BOVAGE/glucosense/prototype/diagrams/1_system_architecture.png

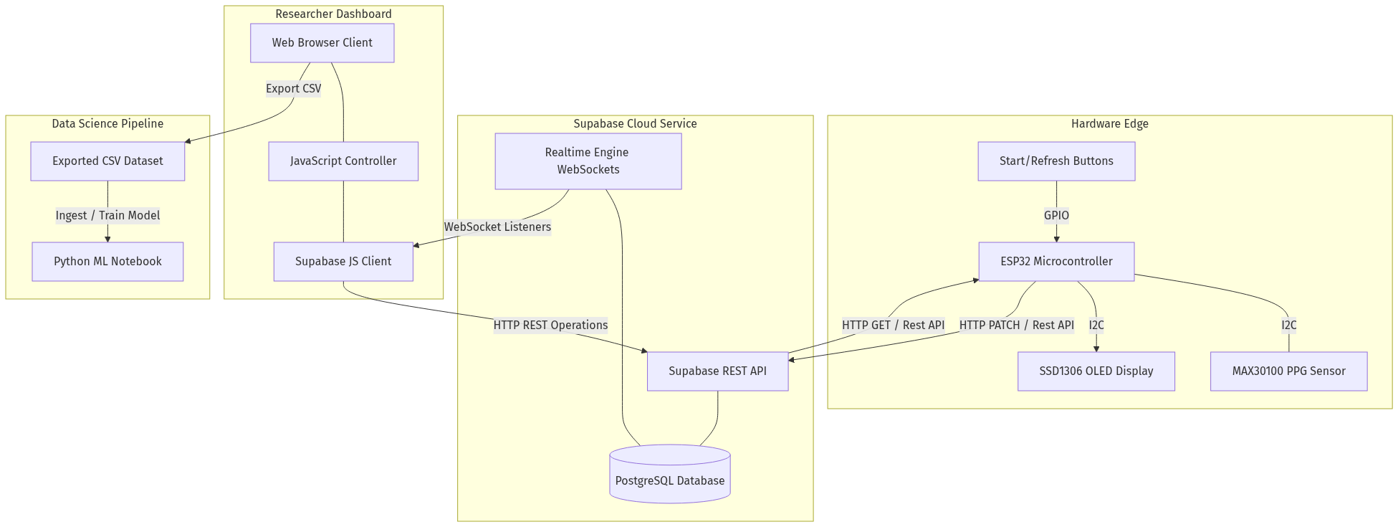
prototype/diagrams/1_system_architecture.png
