BOVAGE/glucosense/prototype/diagrams/2_database_schema.png

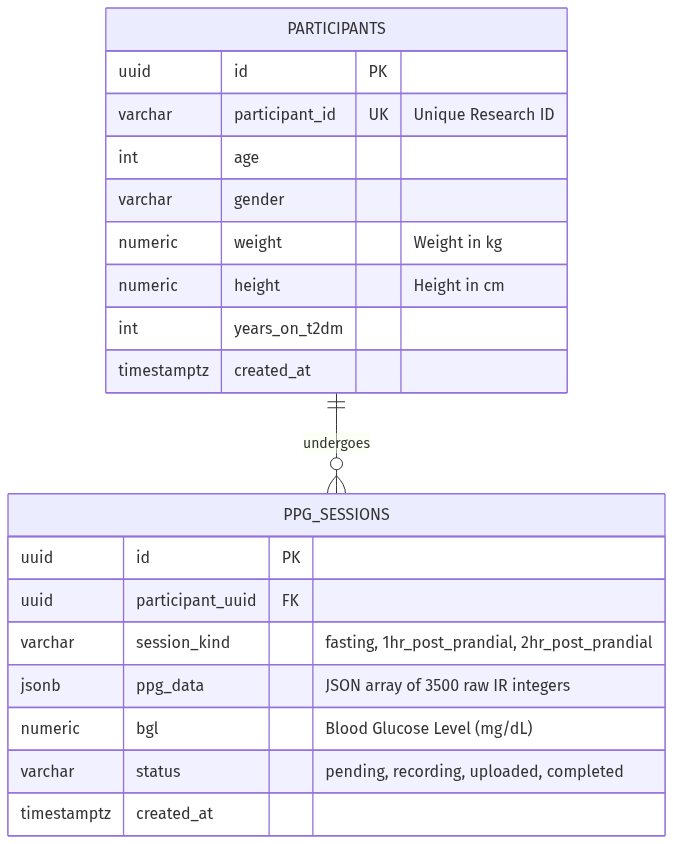
prototype/diagrams/2_database_schema.png
