BOVAGE/glucosense/prototype/diagrams/3_use_cases.png

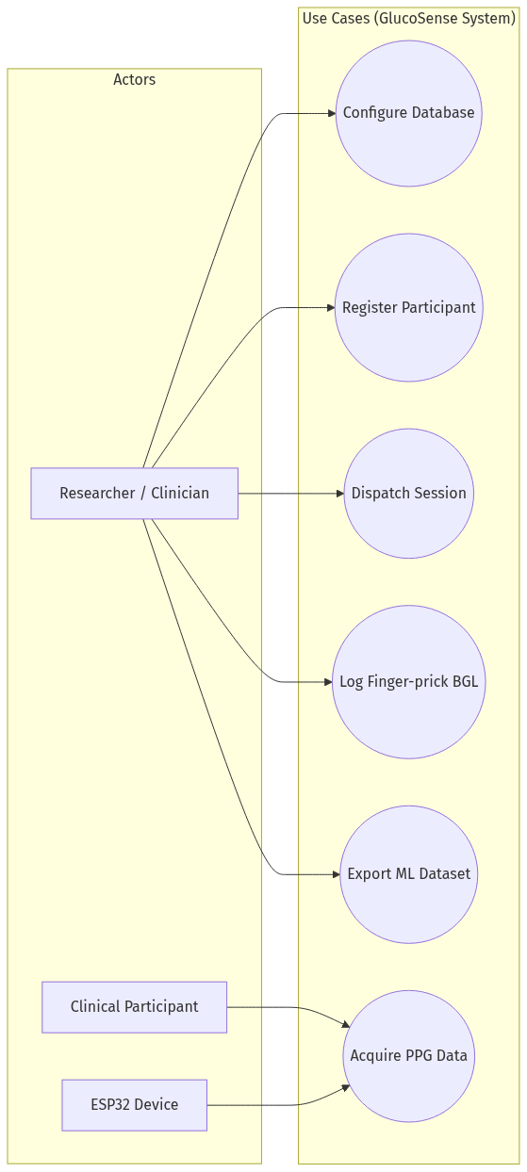
prototype/diagrams/3_use_cases.png
