BOVAGE/glucosense/prototype/diagrams/4_system_sequence_flow.png

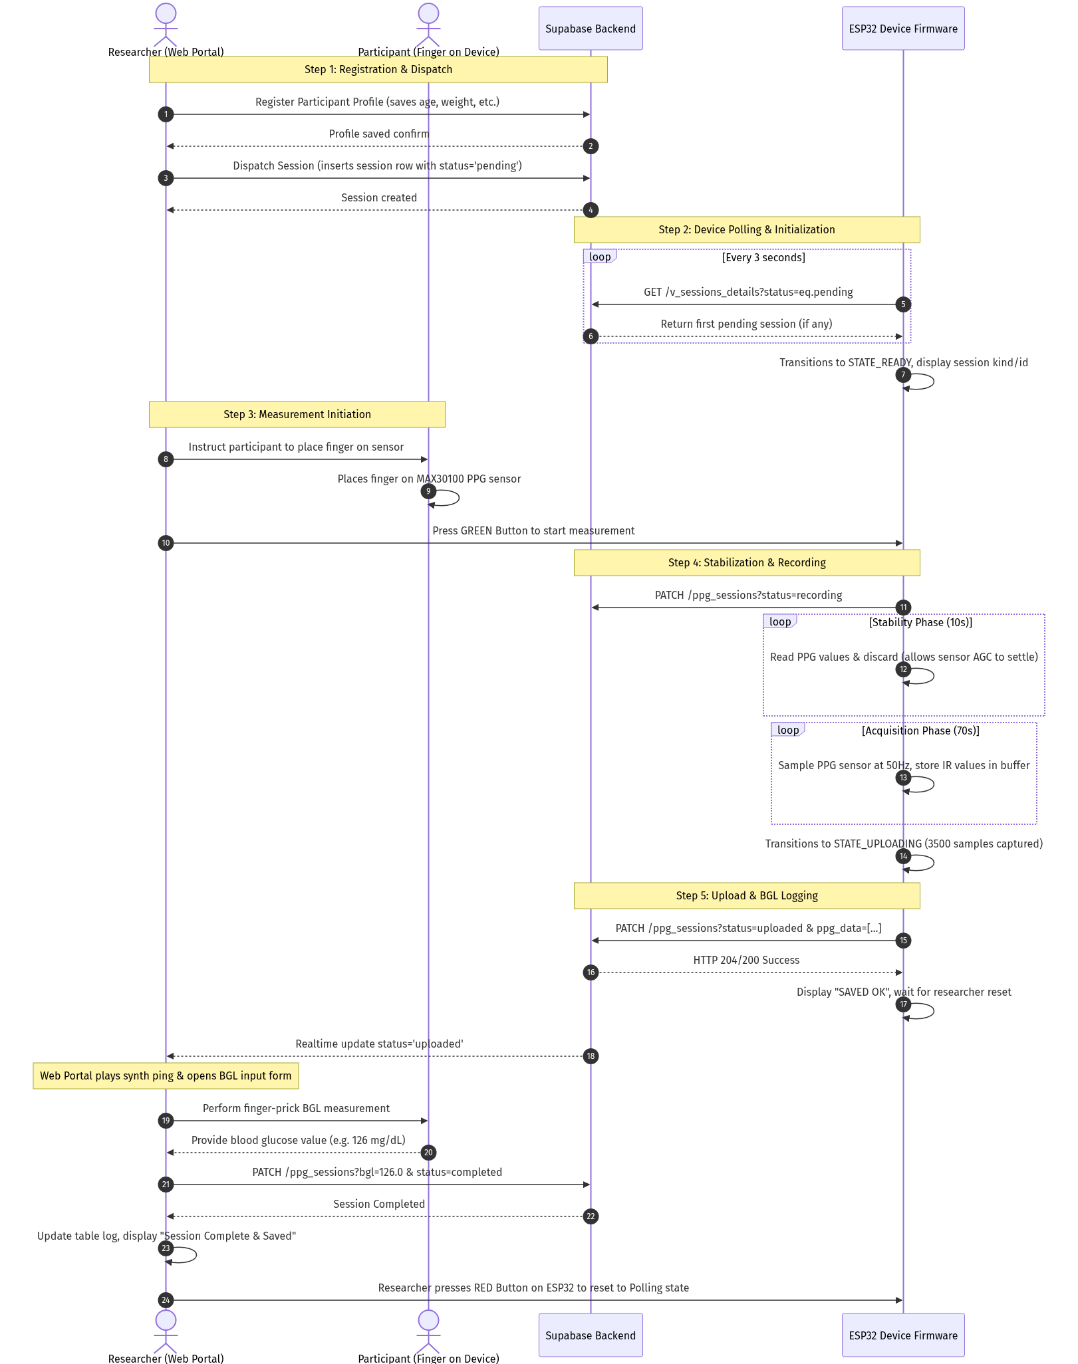
prototype/diagrams/4_system_sequence_flow.png
