BOVAGE/glucosense/prototype/diagrams/5_firmware_state_transitions.png

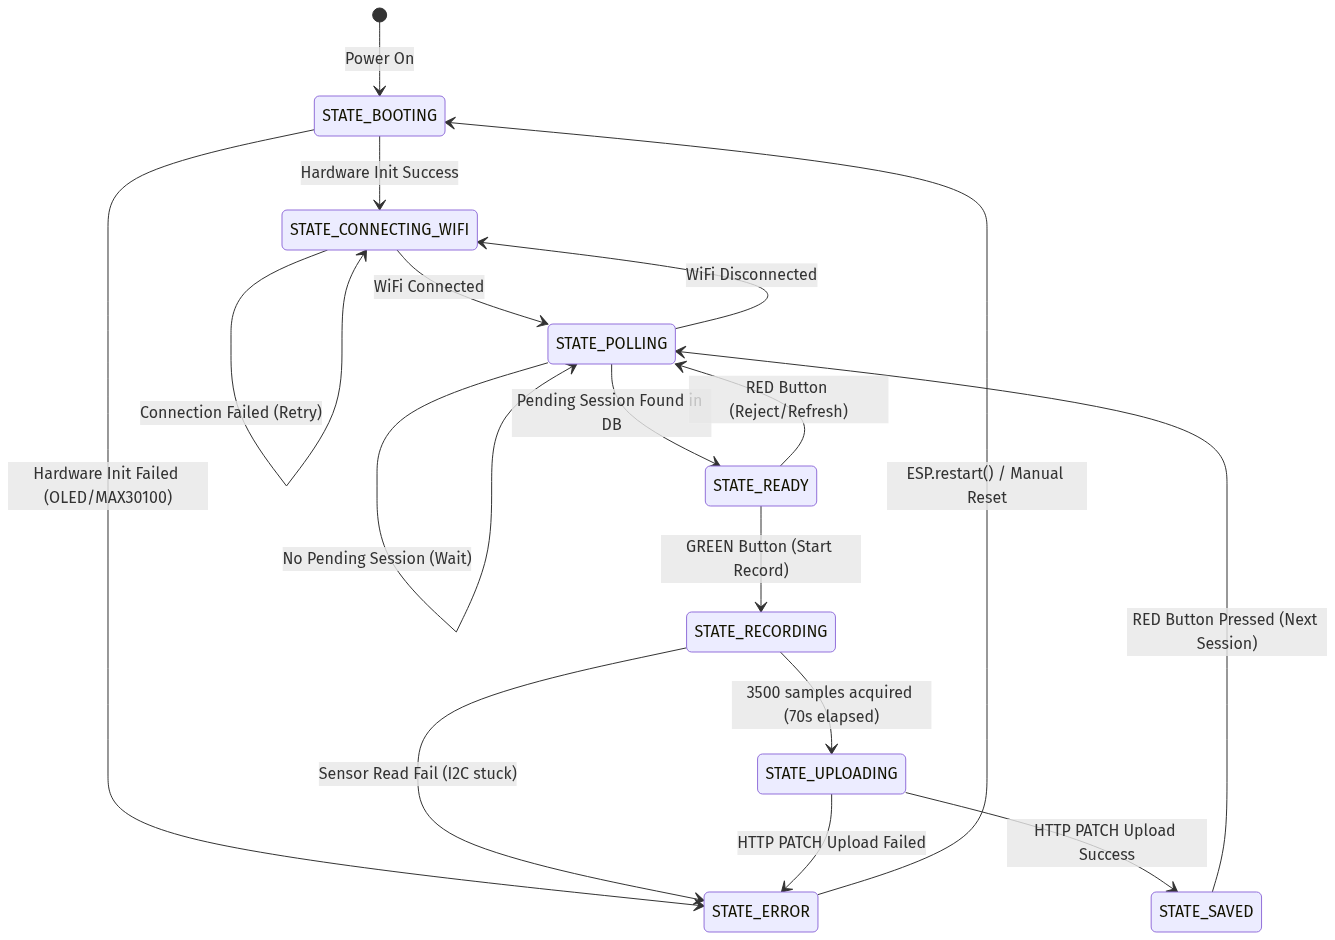
prototype/diagrams/5_firmware_state_transitions.png
