BOVAGE/glucosense/prototype/diagrams/6_device_functionality_flowchart.png

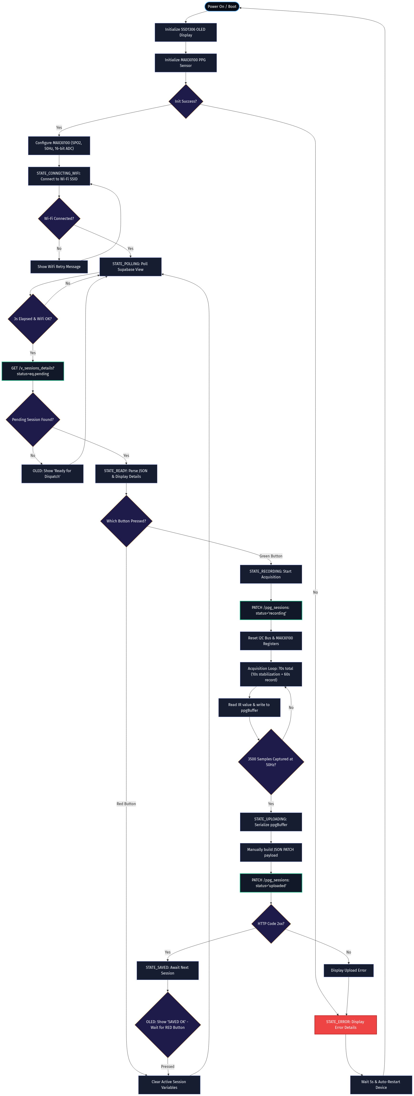
prototype/diagrams/6_device_functionality_flowchart.png
