BOVAGE/glucosense/prototype/diagrams/7_software_system_architecture.png

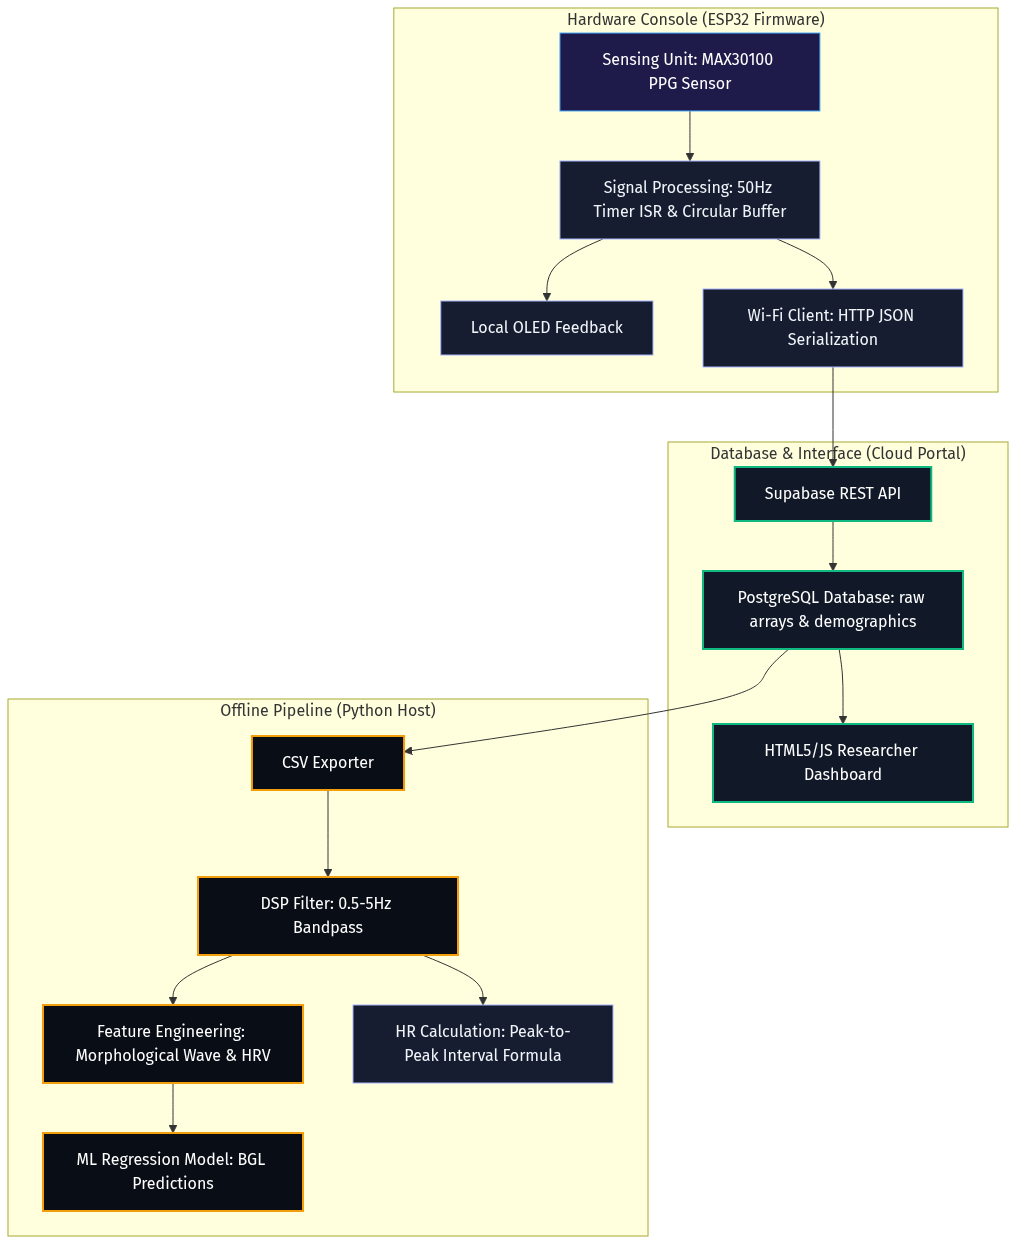
prototype/diagrams/7_software_system_architecture.png
