BOVAGE/glucosense/prototype/diagrams/diagram_2.png

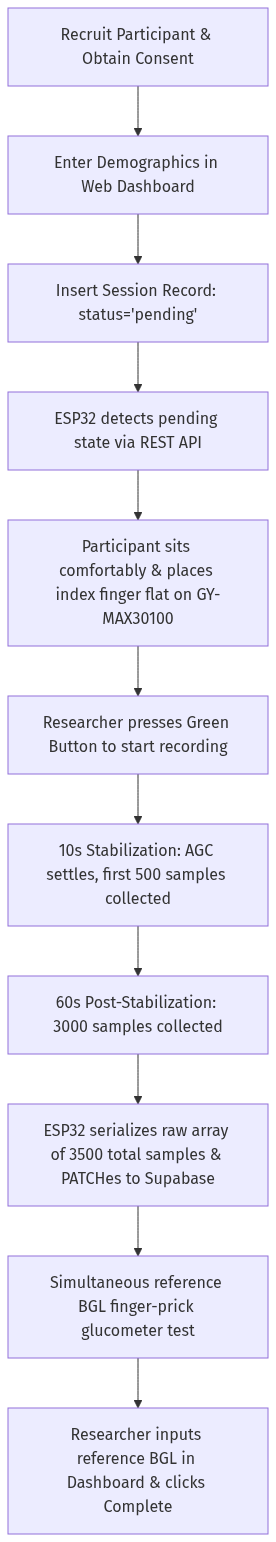
prototype/diagrams/diagram_2.png
