BOVAGE/glucosense/prototype/docs/fyp_circuit.pdf

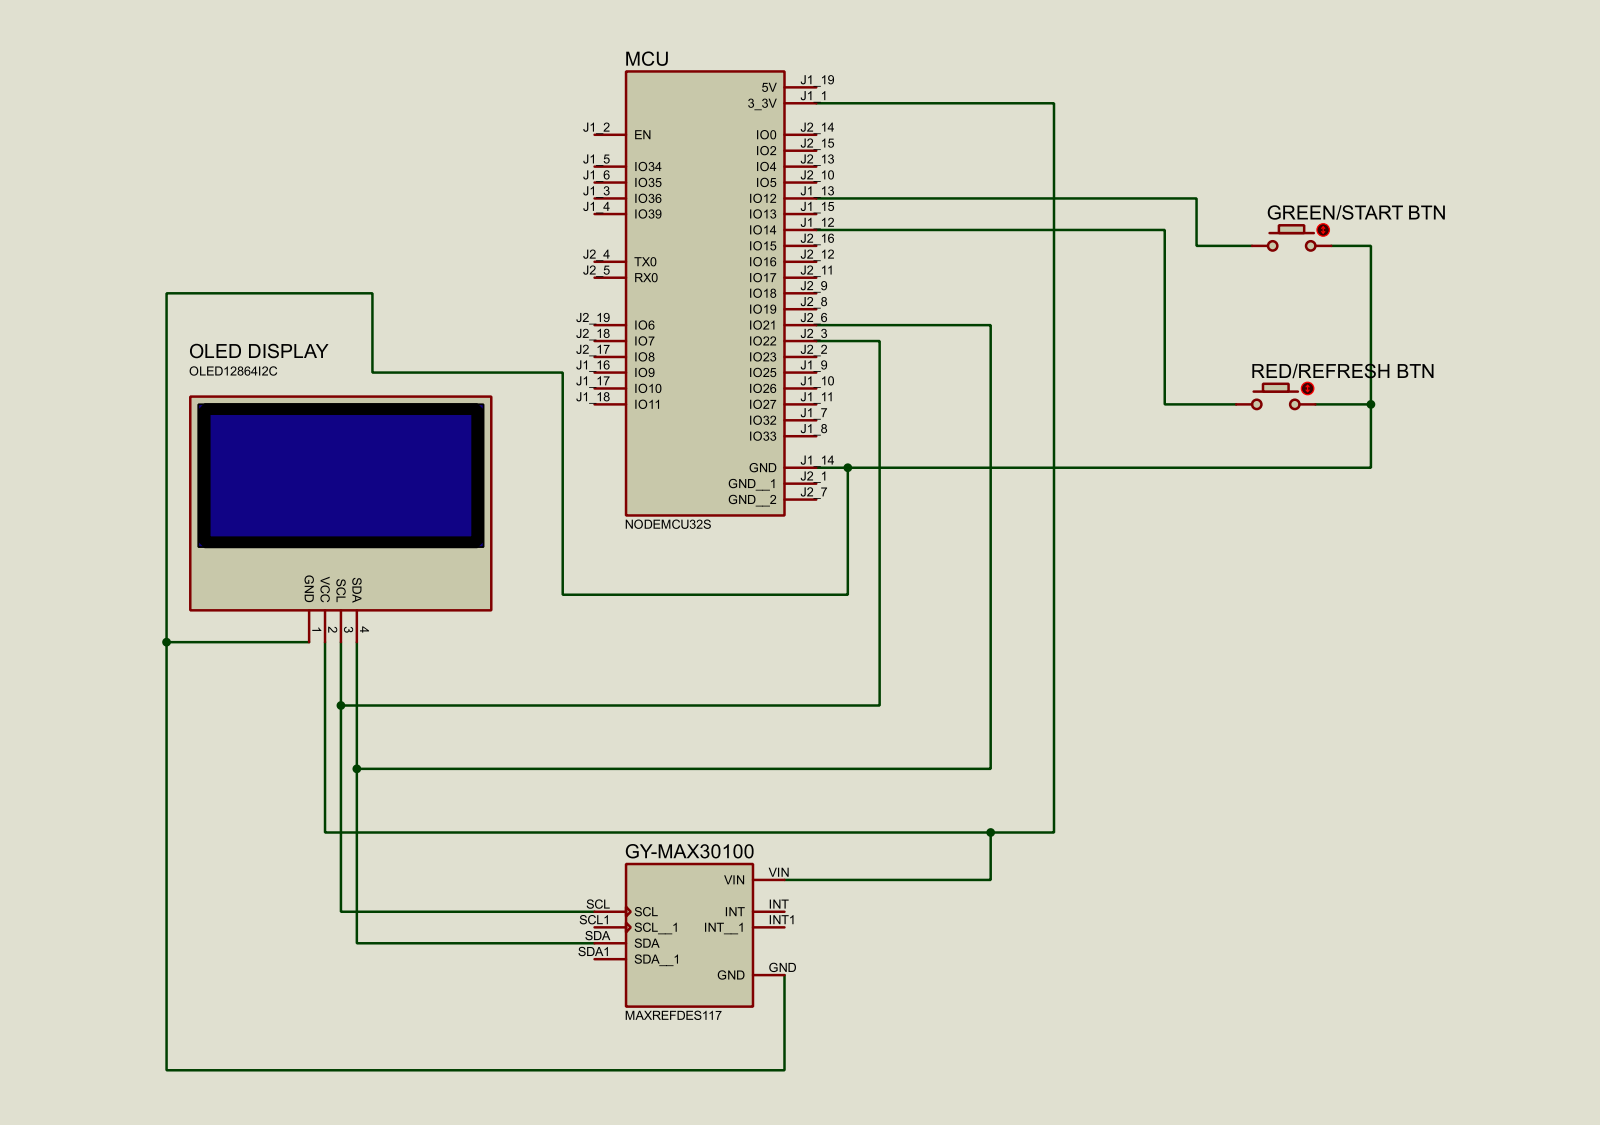
[picture p9: page 1]
