BOVAGE/glucosense/prototype/docs/fyp_circuit_nl.pdf

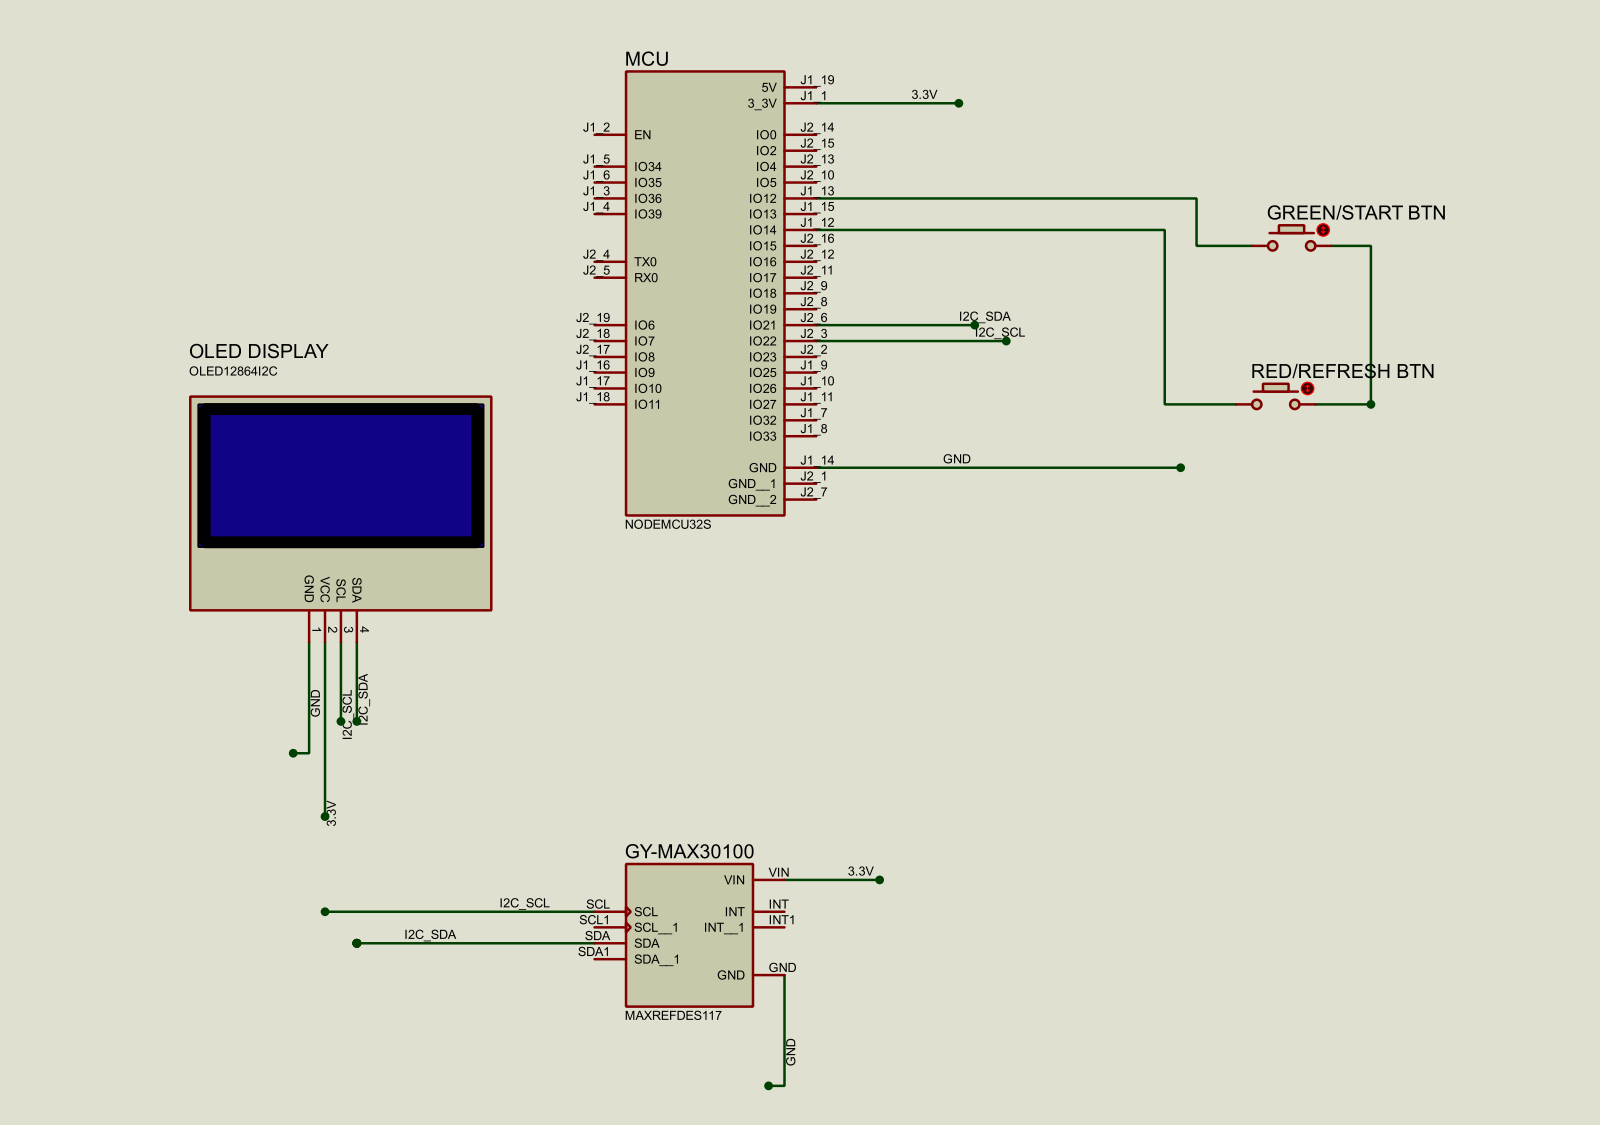
[picture p10: page 1]
